top-gun/SMT50-ESP/documentation/Bodensensor-komplett.jpg

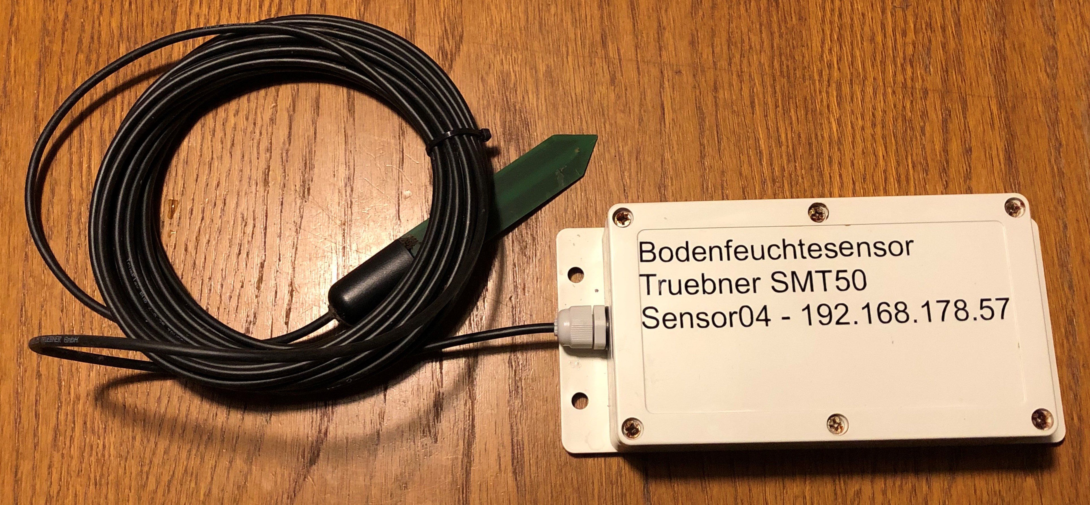
documentation/Bodensensor-komplett.jpg
