top-gun/SMT50-ESP/documentation/trübnersmt50.png

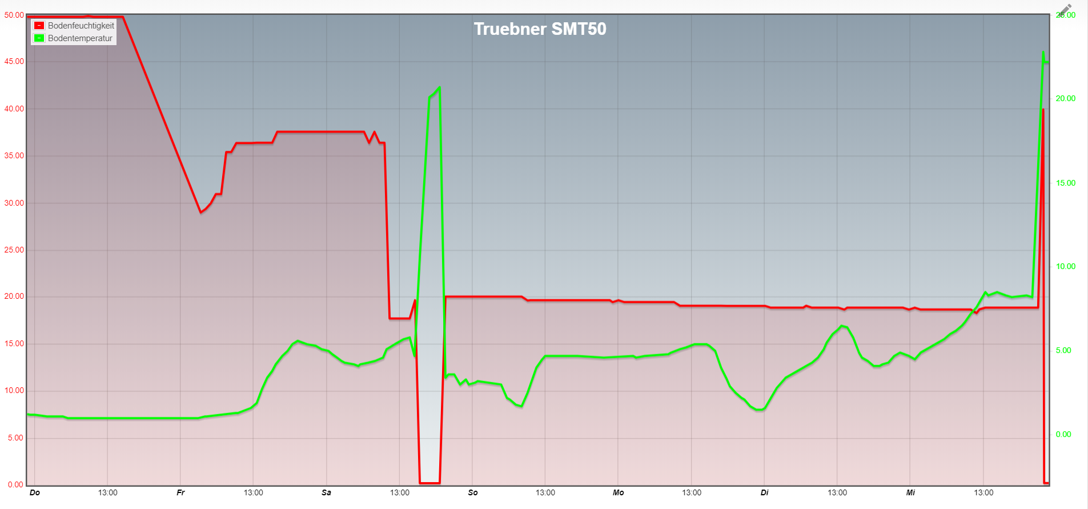
documentation/trübnersmt50.png
