top-gun/SMT50-ESP/documentation/architecture.png

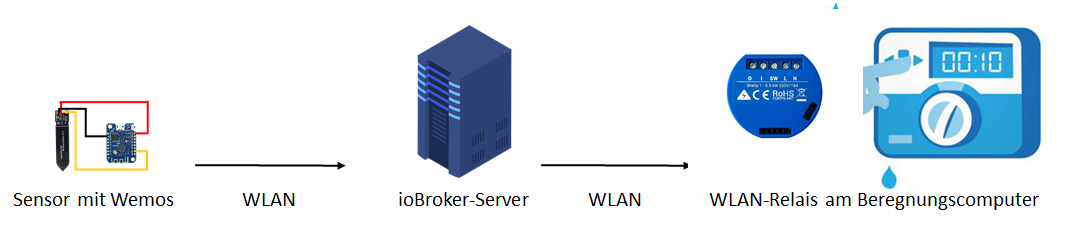
documentation/architecture.png
