top-gun/SMT50-ESP/documentation/Bodensensor-offen.jpg

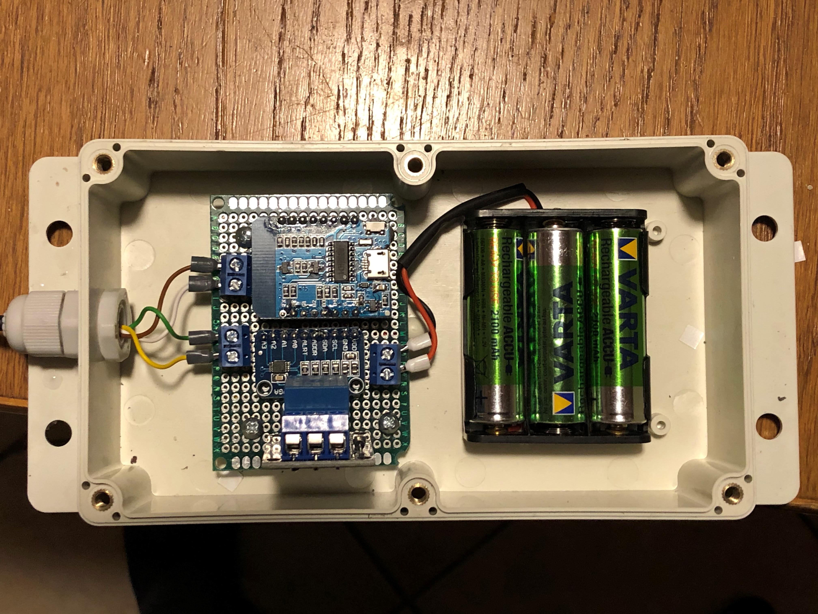
documentation/Bodensensor-offen.jpg
