top-gun/SMT50-ESP/documentation/Sensor-Schaltbild.png

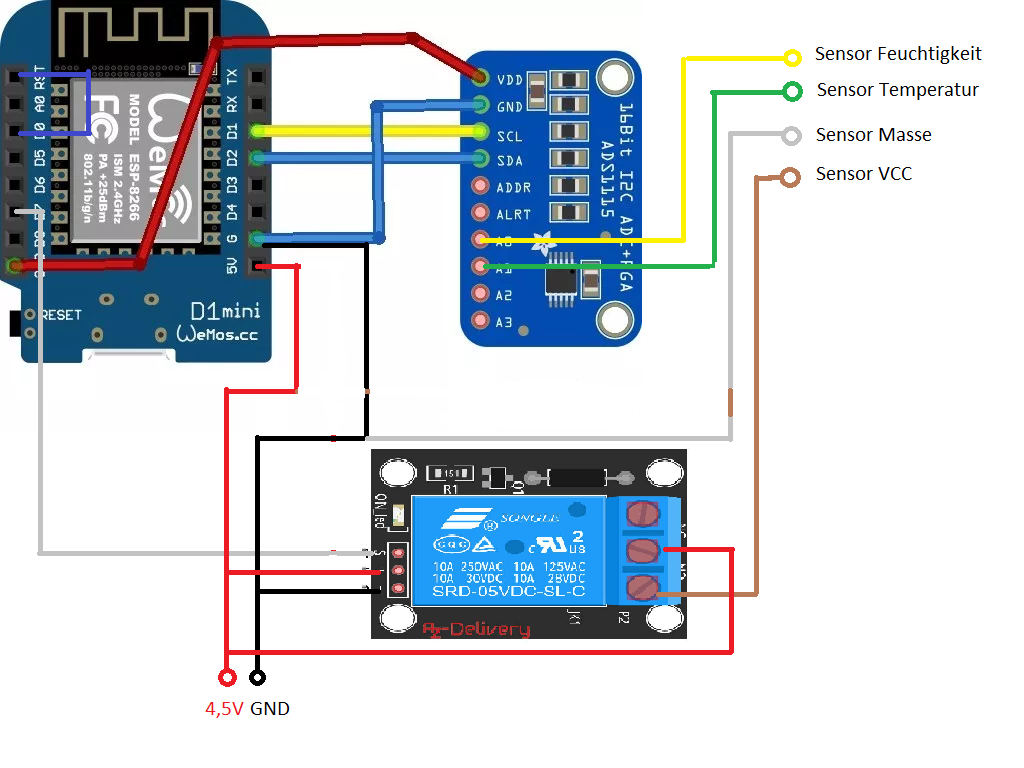
documentation/Sensor-Schaltbild.png
