top-gun/SMT50-ESP/documentation/Sonoff.jpg

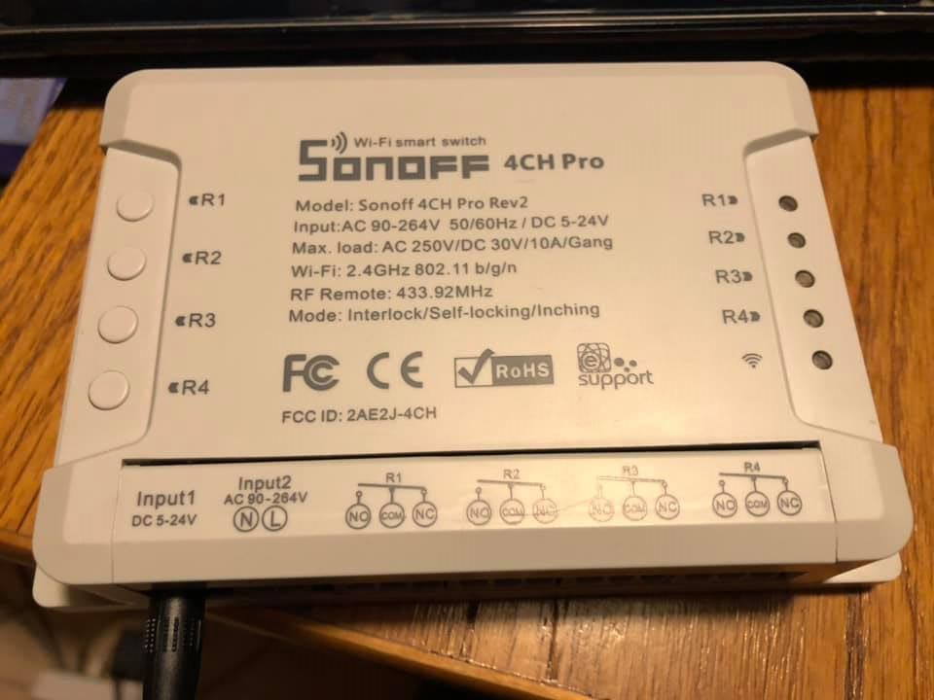
documentation/Sonoff.jpg
