top-gun/SMT50-ESP/(threads)

Thread 4 (2020-07-27):

ADS1115 returns -1

Gorgar91, 2020-07-27:
Hi,
in first, thanks for great idea and solution for that !

in second, have small issue here, which i hope I will solve ... what ever i do, your code return me as results for voltage reads -1 , when i used esp easy , ads working fine, get results, also when i used ads basic Arduino example , I do get correct results .. is very strange to me as your code looks identical .. no special stuff regarding that ADS, I was into,  my ads is broken, but it works with other code ?!  ... only difference is, they put readings in loop part and you have it in setup, even i put it down into loop, turn off sleep , still get results -1 , any clue why ? what can be wrong ? ordered another ADS1115 just to try it , even i dont believe is broken ...  please advise.

+question - soil moisture  - when do you start your irrigation on which percentage ? and when do you stop it ? how deep you put sensor ?

this one is working fine : i do not see difference :(
[sketch_jul25b.txt](https://github.com/top-gun/SMT50-ESP/files/4981101/sketch_jul25b.txt)

top-gun, 2020-07-27:
Hi Gorgar91,

did you pull a release or the master? I recently discovered one inconsistency between wiring and code. The wiring plan does not connect the address-pin to any of the options, so it's set to the default address. My sketch was written for a different address.

This was changed for "master", which works correctly at the default address 0x48.

My older releases are coded for address 0x4a.

Gorgar91, 2020-09-04:
Hi,
I do apologize for late reply on this, I finally get it working ! , very happy about it . .. i did replace ADS by different one - was a trick to solve, even was very strange to me as on basic sketch "old" one worked also.. anyway thanks for help and info about your timing ! will keep an aye on it for while, then i will check what is correct % for my soil .. so far is 50% as i seed just few days ago :)

Closed 2020-09-04.

Thread 6 (2020-10-23):

Sensor04-Truebner-SMT50.ino

mat130780, 2020-10-23:
Interessantes Projekt! Mir ist noch nicht ganz klar, wohin [dieser Code](https://github.com/top-gun/SMT50-ESP/blob/master/Wemos/Sensor04-Truebner-SMT50.ino) kopiert werden soll. Ich habe meinen Wemos D1 bereits mit Tasmota geflasht und vor dem Kompilieren den ADS1115 aktiviert. Muss ich den Code vor dem Kompilieren irgendwo einfügen?

top-gun, 2020-10-24:
Kennst Du die Arduino Programmieroberfläche? Da kommt der Code rein, und wird von dem Programm auch auf den Wemos geflasht. Tasmota macht man anders, da gibt es fertig kompilierte Dateien. Bevor Du das hier umsetzen kannst, musst Du dich mit der Arduino-Entwicklungsumgebung befassen. Kein Hexenwerk, es gibt viele gute Guides im Web.

Closed 2020-10-30.

Thread 7 (2020-11-11):

Use loop() to receive MQTT callback reliable

MasterRay2, 2020-11-11:
Super Projekt. Lief bei mir dank toller Anleitung auf Anhieb. Vielen Dank.

Lediglich der MQTT callback kam so gut wie nie an. Mein Broker ist wohl zu langsam. Ich habe daher die Abfrage in die loop() verfrachtet. Die boolesche Variable callback_done  wird entsprechend in callback() gesetzt. Die Integer-Variable max_runtime enthält die Millisekunden bis zum Timeout.
Jetzt geht's problemlos.

```
void loop()
{
  mqttClient.loop();

  // looping until MQTT callback has been received or timeout is reached
  if ( callback_done || millis() > max_runtime ) {

    // deep sleep now
    WiFi.disconnect( true );
    delay( 100 );
    ESP.deepSleep(Minuten * DS_Intervall, WAKE_RF_DISABLED);
    delay( 100 );

  }
}
```

Thread 8 (2020-12-30):

connection to mqtt

Matt77CHE, 2020-12-30:
Hallo und guten Morgen

Ich hab da  mal ne Frage;

Meine mqtt -Geschichte läuft mit Benutzernamen & Pw; dies kann im code jedoch nicht hinterlegt werden..
? kann ich bei const char* mqtt_server =...... einfach noch zwei Linien einfügen mit dem Bn & dem Pw ? (wenn ja, - wie?)

... muss man bei der IP Adresse des mqtt servers den Port nicht angeben?

Habe ich dann, wenn alles funktioniert im iobroker in den Objekten unter sonoff; shelly oder so ein neues Objekt mit dem ich weiterarbeiten kann?
Wie du siehst, bin ich nicht gerade der pro auf diesem Gebiet...

Freundliche Grüsse
Matthias

Matt77CHE, 2020-12-30:
.. update 1;
die Angabe über den Port habe ich weiter unten im code gefunden;

top-gun, 2020-12-31:
Dafür gibt es direkt beim Pubsubclient (der verwendete Library) ein Beispiel:

https://github.com/knolleary/pubsubclient/blob/master/examples/mqtt_auth/mqtt_auth.ino

Closed 2021-03-02.
