top-gun/SMT50-ESP/(commit log)

2020-01-18 Update Sensor04-Truebner-SMT50.ino
    Minor optimization: Now, the sensor is read and turned off before wifi gets activated. This takes about 0.4s longer, but saves power because the relay won't stay powered for long.
    [Sensor04-Truebner-SMT50.ino]
2020-01-19 Make Intervall adjustable
    The sensor will now create a new value "Intervall" in the sensor-mqtt-data. User may configure the sleep-time in minutes from 1 to 60 minutes. If no value is set, the sensor will report every 30 minutes.
2020-01-19 Update Sensor04-Truebner-SMT50.ino
    mainly comments cleaned up and more translation work
2020-01-19 Update Sensor04-Truebner-SMT50.ino
    minor fixes
    [Sensor04-Truebner-SMT50.ino]
2020-01-20 Initial drawing of the sensor-module
2020-01-26 more wifi-optimization
    turn off wifi before sleep, keep it off until the sensor is read
    re-use old bssid and channel if possible
    store bssid and channel in rtc-memory over deep sleep
2020-01-27 Re-activate serial print of IP-address
2020-05-23 Update ADS1115-address
    Since the wiring shows no bridge from "ADDR" on the ADS-1115, the converter uses 0x48 on the I2C-bus.
